SergeyTomp/GSM_Thermometer/additions/images/menu.pdf

вход по нажатию кнопки или по требованию системы

При отсутствии датчиков в памяти:

Сообщение: "Замена/Добавление"

Сообщение: "Всего устройств 0"

Сообщение: "Подключите устр. и нажмите кнопку"; Ожидание 15 с до нажатия кнопки, подтверждающего подключение датчика к линии

при подключении и подтверждении коротким нажатием:

при условии обнаружения нового датчика:

Сообщение: "Найдено новое устройство"

При наличии в памяти ячеек с датчиками, от которых не получен ответ при стартовом опросе:

Предлагается пункт: "<имя > Заменить?"

При согласии предложенный неактивный датчик заменяется новым обнаруженным

При отказе и наличии других неактивных датчиков в списке предлагается к замене следующий

При отказе от замены последнего предложенного датчика и отсутствии других неактивных в списке:

Предлагается пункт: "Добавить?"

При согласии и наличии свободной памяти в конце списка:

Датчик добавляется с именем "Sens.<№ по порядку>"

Сообщение "Замена выполнена", далее - выход из меню

При согласии и отсутствии свободной памяти в конце списка:

Сообщение: "Память заполнена", далее — выход из меню

При отказе от пункта "Добавить?" - выход из меню

При отсутствии в памяти ячеек с датчиками, от которых не получен ответ при стартовом опросе:

при отсутствии подтверждения нажатием кнопки в течение 15 с - выход из меню в случае отсутствии на линии датчика, отличного от записанных в памяти:

Cообщение: "Новых устр-в нет", далее - выход из меню

При наличии датчиков в памяти:

Предлагается пункт: "Удалить?"

При согласии предлагается к удалению первый датчик по списку — выводится <имя>

При согласии датчик удаляется из списка в памяти

Сообщение: "Удалено"

Если в памяти остался хотя бы один датчик - выход из меню

Если в памяти не осталось датчиков:

Сообщение: "Нет датчиков", далее переход к началу меню

При отказе и не пустом списке датчиков в памяти, предлагается к удалению следующий датчик по списку — выводится <имя>

При отказе и пустом списке датчиков в памяти - переход к разделу "Замена/Добавление"

Выход из меню

Структура меню работы со списком датчиков в памяти устройства
