SergeyTomp/GSM_Thermometer/additions/images/scheme.jpg

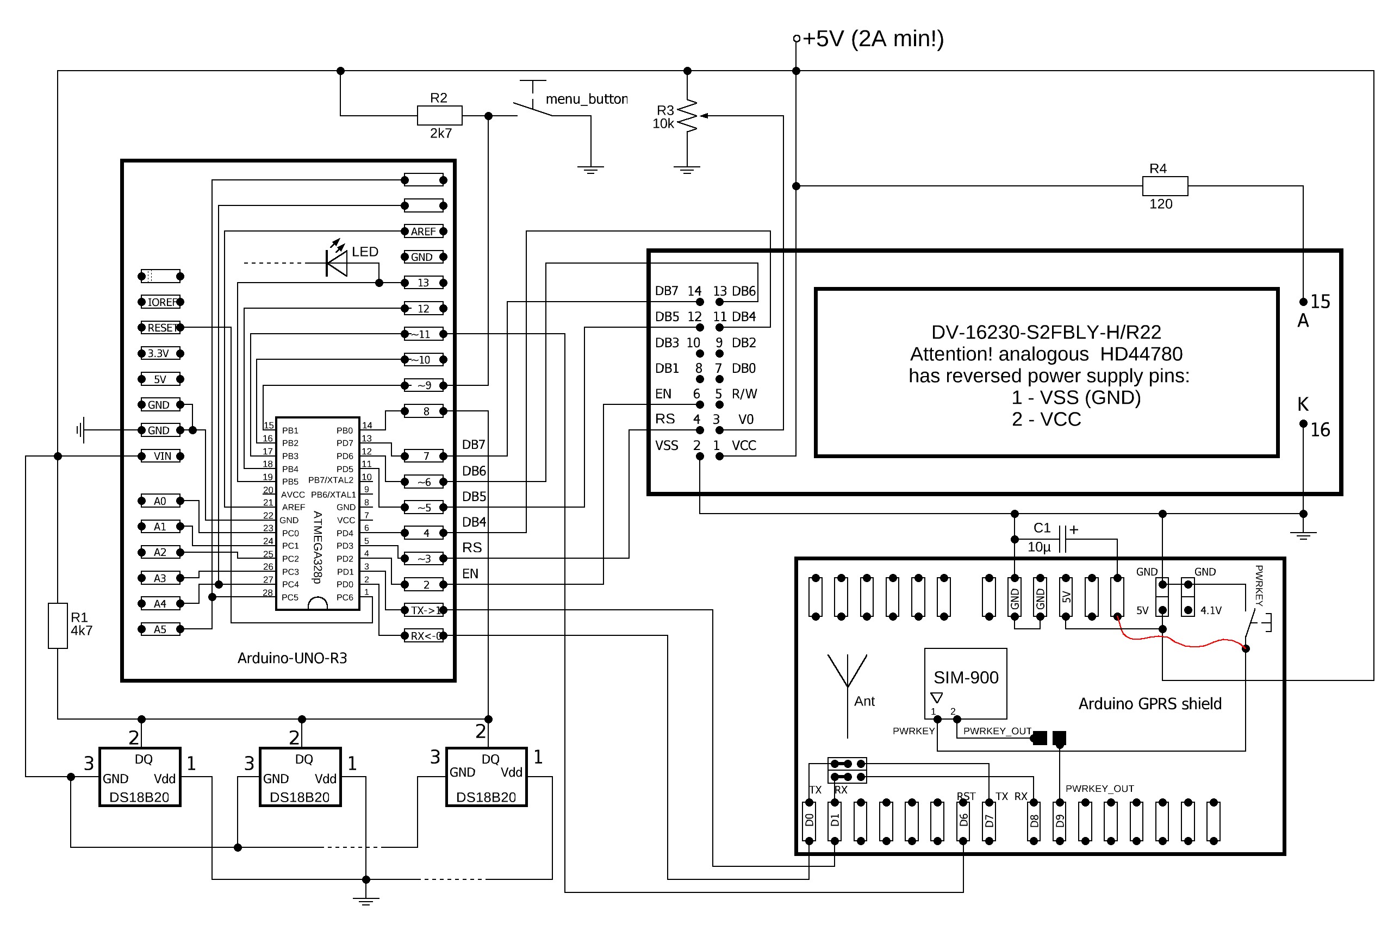
additions/images/scheme.jpg
