SergeyTomp/GSM_Thermometer/(list of files, drawings)

Other design files:
additions/sources/scheme.spl7
