SergeyTomp/GSM_Thermometer/(commit log)

2020-02-19 version 1.0.0:
    доработанная версия из сети - ищет все датчики, а не только 2.
    - исправлен алгортм поиска из сети в варианте записи кодов сразу в многострочный массив в ОЗУ в отличие от классического алгоритма из appnotes - через буферный однострочный массив
    - индикация температур на жк-экран в одной строке, цифры чередуются по кольцу
    - добавлена перекодировка русских символов
    [scheme.spl7]
2020-02-19 version 1.1.0:
    - все текстовые строки и массив переведены во флэш
2020-02-19 version 2.0.0:
    - переработан алгоритм поиска на классический вариант через буферный однострочный массив,
    - запись кодов найденных устройств в массив структур в еепром
    - в структуре в еепром предусмотрено место для записи имени датчика и диапазонов температур
2020-02-19 version 2.1.0:
    - индикация в две строки
    - имя датчика по умолчанию формируется по шаблону с индексированием номера
    - если больше 2-х, автоматически добавляется следующий экран
    - автоматическое чередование экранов
2020-02-19 version 3.0.0:
    - код поиска датчиков выделен в отдельную функцию
    - в режим поиска входим при нажатой кнопке на PORTB1 при рестарте
    - основная программа стартует прямо в режиме отображения по кодам, записанным в еепром
    - количество устройств в епром пишется в последнюю ячейку 1024 (0х0400)
    - если датчика нет, показания = -00
2020-02-19 version 3.1.0:
    - переработан вывод на дисплей - устранено мерцание и задержки вывода на экран при его обновлении
    -> для верхней и нижней строк дисплея созданы отдельные структуры
    -> сначала имя и температура записывается в структуру верхней или нижней строки, потом выводится на экран
2020-02-19 version 3.2.0:
    - проверка CRC8 выделена в отдельную функцию
    - она принимает указатель на массив байтов, номер последнего байта с правильным значением CRC8* и номер устройства.
    * - нужно для универсальности, поскольку проверять может быть нужно разное количество байт, например 9 для scrathpad или 8 для ID.
2020-02-19 version 3.2.1:
    - в случае несовпадения CRC в блоке проверки выводится сообщение по каждому датчику с ошибкой, "выводов" не делается, просто пока идём дальше по main
2020-02-19 version 4.0.0:
    - в структуру описания датчика добавлен параметр флага присутствия
    - добавлена функция чтения блокнота для опроса присутствия при входе без первичной дешифрации адресов
    - в блоке проверки CRC после первичной дешифрации введён счётчик датчиков, прошедших проверку, организован вывод на экран №№ датчиков с ошибкой и количества прошедших проверку по окончании
    - в блоке подг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
2020-02-19 version 4.1.0:
    - убраны костыли формирования символов для дисплея:
    -- цифры формируются в main, а не в подготовке кадра
    -- в подготовку кадра из main передаются сразу коды символов цифр и знака, либо коды символа ? при сброшенном флаге присутствия;
    - функция Disp_prep переименована в Frame
    - temp_sign переведена из глобальных в main, в цикл опроса датчиков
2020-02-19 version 4.2.0:
    - активировано прерывание по переполнению счётчика timer0
    - добавлен обработчик для опроса кнопки, определения длительности нажатия - длинный/короткий жим
    - в бесконечный цикл в main вставлен тестовый блок переходов по факту нажатия кнопки, пока просто индикация на дисплее
    - объявление и инициализация переменных бесконечного цикла измерения температур выенесена в инициализи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
2020-02-19 version 5.0.0:
    - добавлена функция замены-добавления устройств add_ID
    - "забытый" кусочек стартового сброса и запроса присутствия перенесён из функций search_ID и add_ID в функцию find_ID
    - заход в функцию add_ID из main-while(1)-for() по длинному жиму
    - при возврате счётчик for() обнуляется для возобновления индикации с начала
    - для однозначности расположения устройства, за один заход заменяется/добавляется только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
2020-02-19 version 5.1.0:
    - в структуре device переменнная flags заменена на битовое поле flags типа bit_set
    -- определено 4 нижних бита: флаги присутствия, выхода за нижний или верхний пределы температур, пропадание в процессе измерений (нужность обдумывается)
    -- резервные 4 верхних бита
    - по тексту кода buffer.flags заменена на бит buffer.flags.active там, где работаем с этим битом; копирование/чтение buffer.flags в/из епром остало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
2020-02-19 version 5.2.0:
    - добавлен блок удаления устройств в add_ID
    - после удаления остальные ниже по списку сдвигаются вверх на одну строку
    - изменен способ формирования порядкового номера устройства в имени по умолчанию в add_ID, иначе после удаления этот номер генерится некорректно:
    -- в предпоследней ячейке епром хранится значение последнего присвоенного номера
    -- в имя по умолчанию вставляется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
2020-02-19 version 5.3.0:
    - введены комплексные функции работы с дисплеем, работают через простейшие функции
    -- функции вывода на экран принимают координаты символа и строки (нумерация от 0)
    -- функция очистки экрана
2020-02-19 version 5.4.0:
    - при возврате из add_ID после удаления всех устройств принудительно возвращает обратно пока не добавить хотя бы одно
    - при входе в main без проведения первичной дешифрации при n==0 в епром принудительно отправляет в add_ID и крутит пока не добавить хотя бы одно устройство
    - в меню корректировки пропускаются разделы удаления и замены, если n==0
    - в add_ID в блоке сравнения найденного ID с з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
2020-02-19 version 5.5.0:
    - унифицировано преобразование числа в строку через функцию utoa_fast_div на основе быстрого деления на 10 сдвигами и сложениями
    -- принимает число и указатель на массив для кодов символов цифр этого числа
    -- добавлен #define N_DIGS 5 для определения размера массива для кодов символов цифр, т.к. он свой у каждой вызывающей функции
    -- в последний элемент массива ставит завершающий 0, дальш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
2020-02-19 version 5.6.0:
    - устранён потенциальный баг при добавлении номера в стартовое имя из-за передачи указателя как &dev_name [(sizeof dev_name) - N_DIGS ], поскольку sizeof dev_name адекватно работает только при char == 1 байт.
    -- сначала номер конвертируется стандартным путём в массив digits
    -- после этого последние три элемента digits (две цифры и завершающий 0) копируются в dev_name
    - размер массива стартового имени задаётся в de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
2020-02-19 version 5.7.0:
    - в блоке преобразования целой и десятичной частей температуры все операции умножения заменены на сдвиги и сложения, размер бинарника упал на 1кб !!(из-за этого temp_int теперь uint16_t)
    - delay_ms(2000) на индикацию заменён на цикл ожидания накопления счётчика прерываний до 2с, опрос кнопки перенесён внутрь него, теперь реагирует на нажатие сразу
    * фича - после возврата из add_ID при удалении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
2020-02-19 version 5.7.1:
    - активировано прерывание по приходу данных в UDR0
    - написан обработчик прерывания по приходу данных в UDR0 - запись в кольцевой буфер
    - написан кольцевой буфер для приёма данных из UART
    - временно размер кольцевого буфера задан 256 байт, чтобы индексы самосбрасывались при переходе через 255, т.е. пока не применяем маску обнуления.
    - при приходе строки в кольцевой буфер она выводится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
2020-02-19 version 5.7.2:
    - в цикл паузы для индикации добавлен блок распознавания команды переименования датчика и её выполнения
2020-02-19 version 5.7.3:
    - написан кольцевой буфер для приёма данных из UART (отправка по uart пока предполагается без кольцевого буфера, напрямую через загрузку в UDR0)
    - временно размер кольцевого буфера задан 256 байт, чтобы индексы самосбрасывались при переходе через 255, т.е.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
2020-02-19 version 5.7.4:
    - в обработчик перывания TIMER0_OVF добавлен блок индикации уровня сигнала морганием штатным светодиодом ардуины, прицеплен на PORTB5
    - добавлены подтверждения выполнения команд изменения пределов температур и активации sms-извещений
    - добавлена обработка пропадания датчика в процессе опроса в цикле
    -- установка/сброс флага пропадания в процессе опроса в цикле
    -- однократное ин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
2020-02-19 version 5.7.5:
    - введён массив хранения целой части последних измеренных температур с учётом знака для последующей отправки на SMS-запрос
    - добавлены функции отправки символа, массива и строки из флэш по USART по аналогии с таковыми для lcd
    - в тестовом режиме отправляет в терминал сообщения о пропадании датчика в основном цикле
    - в тестовом режиме отвечает на запрос всех температур - выводит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
2020-02-19 version 5.7.6:
    - в обработчике прерывания приёмки данных по USART включена обработка ошибки приёма байта (ошибка кадра) и переполнения буфера, пока выводит сообщение на lcd и в терминал.
    - в ответ на запрос всех температур выводит в столбик имя датчика и температуру со знаком
    - перевод каретки и строки выделены в функцию, чтобы не забивать код лишними 4-мя байтами каждый раз.
    - в имена функций и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
2020-02-19 version 5.7.7:
    - добавлено маскирование индексов, чтобы потом можно было сделать кольцо другого размера
    - расчёт количества байт в кольце сделан в одну строку; немного необычно, но это работает, понятный вариант оставлен в комментариях ниже
    - обработка ошибки кадра перенесена - до чтения из UDR во временную переменную, как должно быть по DataSheet.
2020-02-19 version 5.7.8:
    - добавлен кольцевой буфер на отправку по USART
    - написан обработчик прерывания по факту опустошения UDR0 передатчика; грузит байты в UDR0 из кольцевого буфера, пока не опустошит его, потом запрещает себя и стоит, пока кто-то не разрешит его работу снаружи
    -- прерывание активируется в в main после формирования посылки в кольцнвом буфере
    -- выключается в обработчике по факту опустош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
2020-02-19 version 5.7.9:
    - пробую формировать текст смс через конкатенацию частей для дальнейшего использования в обработчике отправки смс через вызов функции перелива теста смс в кольцевой буфер отправки.
    - сделана отправка объединённой строки строки при аварии на линии.
    **! в начале цикла поиска устройств в add_ID потенциально лишний кусок проверки превышения лимита епром, поскольку это делается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
2020-02-19 version 6.0.0:
    в главном цикле меню и индикация переведены на режим конечных автоматов, блок работы по UART пока удалён
    Начало main прежнее, изменение только в части принудительной активации КА меню перед главным циклом если n==0, опрос датчиков блокируется (раньше был вызов Add_ID():
    1. Если кнопка нажата при запуске:
    - делаем полный поиск устройств на шине и перезапись найденного в епром
    - srch_done =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
2020-02-19 version 6.1.0:
    добавлен модуль SIM900, в N_RESET добавлено gsm_lvl=0, чтобы не моргал диод на время перезапуска модема; разбор команд пока только "reqest-answer",
    Начало main прежнее:
    - srch_done = 1 - пропускаем начальный опрос линии
    2. Если кнопка не нажата при запуске, т.е. полной дешифрации не было, обновляем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
2020-02-19 version 6.1.1:
    Изменена отправка смс: изменён способ формирования смс для отправки - в задачу записваем не текст, а тип смс и параметры, а хэндлер сразу шлёт нужные строки из флэш в TX_ring
    - добавлен enum для названий шаблонов смс
    - создан тип структура sms_struct:
    > номер шаблона смс (определяет, какие строки из флэш и в каком порядке брать, какие параметры и куда в текст добавить)
    > номер устройства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
2020-02-19 version 6.1.2:
    - добавлен глобальный указатель t_all для обращения к локальному массиву last_t, иначе в to_do не поставить задачу отправки всех температур, не достать до last_t
    - в начале main определяем t_all = last_t
    - по короткому нажатию ставится задача отправки всех температур и оставлен вывод QUICK на lcd
    - в to_do при приёме T ALL ставится задача отправки всех температур
2020-02-19 version 6.1.3:
    - отправка длинных строк в TX_ring сделана без поллинга падения флага UDRIE0 (по сравнению с ds18b20_6.1.1).
2020-02-19 version 6.1.4:
    реализован основной функционал смс-команд
    REN <имя> <новое имя> - переименование
    THAL <имя> <знак><температура> - верхний порог температуры
    TLAL <имя> <знак><температура> - нижний порог температуры
    SMS TL1(0) <имя> - смс при понижени ниже нижнего порога, 1 - вкл, 0 - выкл
    SMS TH1(0) <имя> - смс при повышении выше верхнего порога, 1 - вкл, 0 - выкл
2020-02-19 version 6.1.5:
    - добавил запись '\r\nOK\r\n' в конец RX_ring при переполнении, чтобы чужие длинные смс не зацикливали хэндлер чтения из-за отсутствия ОК после текста
    - добавлен запрос баланса:
    > в парсер добавлен массив money[6] для цифр суммы баланса; static, чтобы можно было передать на него указатель в задачу отправки смс
    > в структуру шаблона смс добавлен указатель на uint8_t для указателя на массив цифр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
2020-02-19 version 6.1.6:
    - уходим от жёстко заданных номеров телефонов - создаём в озу глобальную структуру с массивами, в них телефоны при запуске будут копироваться из сим-карты; пока символы заданы жёстко, из флэш строки удалены
    - в хэндлере отправки команды добавлена конкатенация по указателю на массив в озу, т.к. телефоны будут в оперативке (это дальше будет нужно при отправке команд работы с з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
2020-02-19 version 6.1.7:
    - в хэндлере отправки команд теперь 4 параметра - указатель на команду из флэш, указатель на массив-строку в озу и два указателя на строки во флэш, нужно для работы с сим-картой
2020-02-19 version 6.1.8:
    - отправка команд тепрь нанапрямую в TX-Ring, без промежуточной сборки во временном буферном массиве
2020-02-19 version 6.1.9:
    - поиск текста смс в ответе модема теперь через отсчёт шестой кавычки, а не заданием смещения от начала строки ответа (жёсткое смещеини может работать не корректно при наличии телефона отправителя в сим)
2020-02-19 version 6.2.0:
    пока без изменений 6.1.8 - 6.1.9, добавлю после отладки, - включаем рабту с сим-картой
    - телефоны пользователей и баланса хранятся в сим-карте и оттуда копируются в озу при загрузке
    - увеличены TODO_MAX (25), TX_RING_SIZE (64) и cmd_txt(50) в send_cmd, иначе не влезают длинные команды работы с записной книгой сим (36 символов в CPBW). cmd_txt уйдёт, не критично
    - добавляем авторизацию пользователей - админ и обычн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
2020-02-19 version 6.2.1:
    применены изменения из 6.1.8 и 6.1.9
    - удалены промежуточные буферы формирования команд перед отправкой их в TX-Ring
    - снято ограничение на длину имени абонента в записной книжке сим (см.6.1.9)
2020-02-19 version 6.2.2:
    - работать с записной книжкой сим только по имени абонента, без указания номера ячейки, очень неудобно - клонируются записи; для добавления номера ячейки в группу команд AT+CPBx увеличиваем список аргументов send_cmd
    > [AT+CPBx=]
    > [№ ячейки,"]
    > [номер телефона]
    > [",145,"]
    > [user_x]
    > ["]
2020-02-19 version 6.2.3:
    - USER_0 заменён на ADMIN
    - исправлена ошибка позиционирования указателя в блоке первой регистрации админа (строка 1574 - 1579)
    - в массиве телефона админа перед первой регистрацией не должно быть + вначале
    [main.c]
2020-02-19 version 6.2.4:
    - в блоке первой регистрации админа (строка 1574 - 1590) заменена установка указателя - вместо жёсткого смещения на 23 ищем третьи кавычки
2020-02-19 version 6.2.5:
    добавляем авторизацию и права доступа пользователей
    - в ISR(USART_RX_vect) при ошибке кадра добавлено чтение буфера без записи в кольцо, иначе флаг FE (frame error) в UCSR0A не сбросится.
    - добавлен user_2 в массив телефонов и строка во флэш
    - добавленj phones.ans_to для фиксации юзера, запросившего баланс
    - добавлены ABNT_1 и ABNT_2 в enum для лучшей читаемости идентификаторов юзеров
    - в структуру шаблона смс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
    [main.c]
